enkhbold470/spinner/media/bottom.png

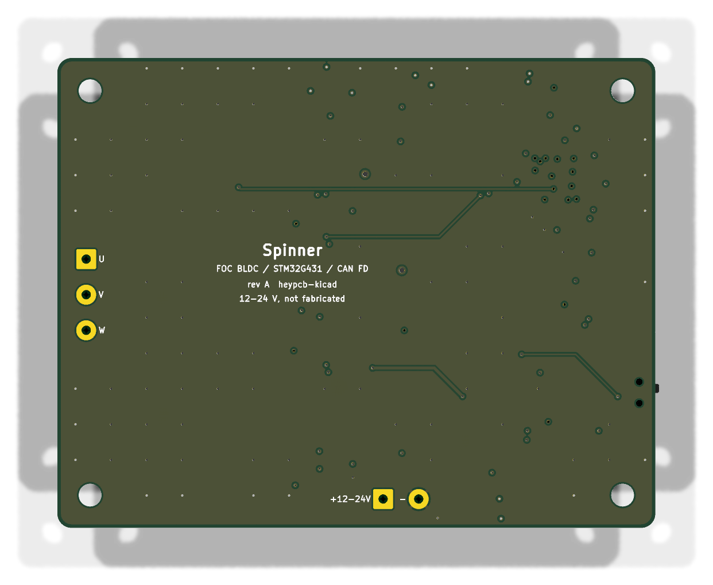
media/bottom.png
