enkhbold470/spinner/media/top.png

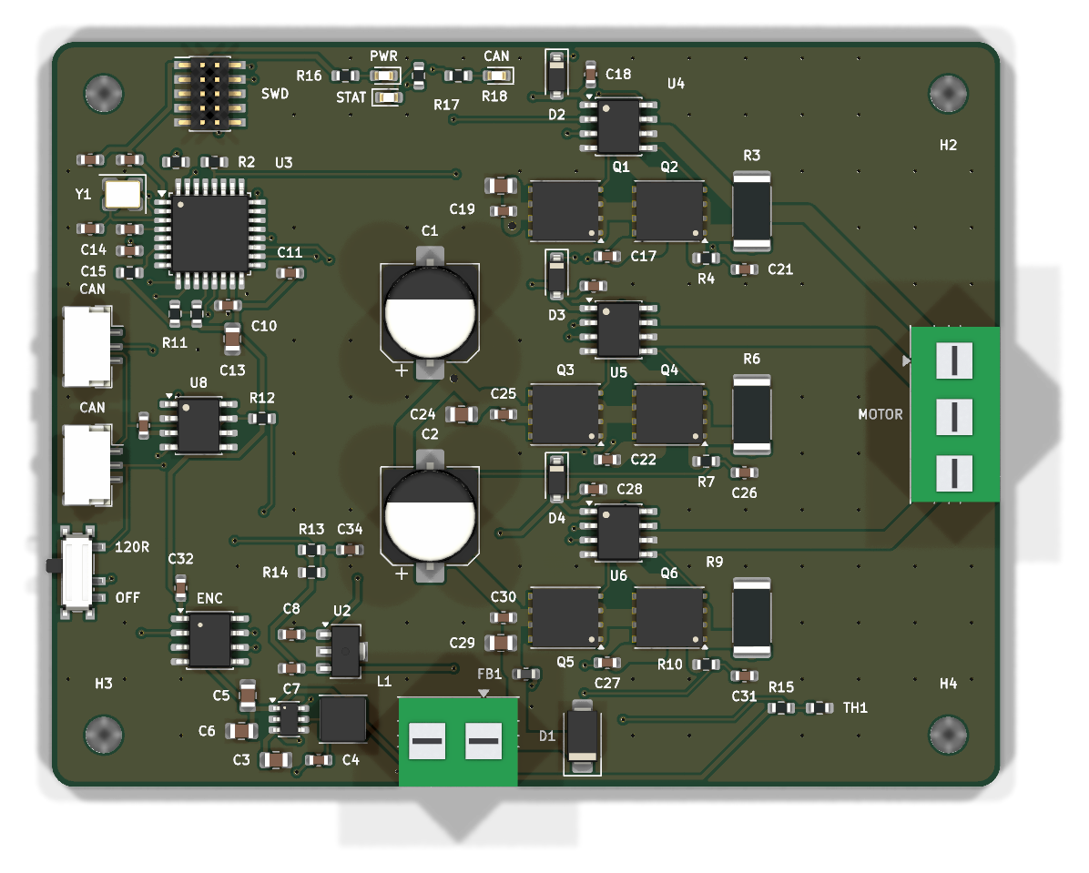
media/top.png
