enkhbold470/spinner/fab/spinner_bom.csv

Reference | Value | Footprint | MPN | LCSC | Qty
C1,C2 | 220uF 35V | Capacitor_SMD:CP_Elec_8x10.5 | UCD1V221MNL1GS | C136294 | 2
C3,C19,C24,C29 | 10uF 50V | Capacitor_SMD:C_0805_2012Metric | GRM21BR61H106KE43L | C440198 | 4
C4,C9,C10,C11,C14,C20,C25,C30,C32,C33,C34 | 100nF | Capacitor_SMD:C_0603_1608Metric | CC0603KRX7R9BB104 | C14663 | 11
C5,C6 | 22uF | Capacitor_SMD:C_0805_2012Metric | CL21A226MAQNNNE | C45783 | 2
C7,C8,C12,C17,C18,C22,C23,C27,C28 | 1uF | Capacitor_SMD:C_0603_1608Metric | CL10A105KB8NNNC | C15849 | 9
C13 | 4.7uF | Capacitor_SMD:C_0805_2012Metric | CL21A475KAQNNNE | C1779 | 1
C15,C16 | 12pF | Capacitor_SMD:C_0603_1608Metric | CL10C120JB8NNNC | C38523 | 2
C21,C26,C31 | 1nF | Capacitor_SMD:C_0603_1608Metric | CL10B102KB8NNNC | C1588 | 3
D1 | SMAJ24A | Diode_SMD:D_SMA | SMAJ24A | C19077541 | 1
D2,D3,D4 | B5819W | Diode_SMD:D_SOD-123 | B5819W SL | C8598 | 3
D5 | Green (PWR) | LED_SMD:LED_0603_1608Metric | KT-0603G | C12624 | 1
D6 | Red (STAT) | LED_SMD:LED_0603_1608Metric | KT-0603R | C2286 | 1
D7 | Orange (CAN) | LED_SMD:LED_0603_1608Metric | XL-1608UOC-06 | C965800 | 1
FB1 | 120R@100MHz | Inductor_SMD:L_0603_1608Metric | BLM18PG121SN1D | C14709 | 1
J1 | VIN 12-24V | TerminalBlock:TerminalBlock_MaiXu_MX126-5.0-02P_1x02_P5.00mm | MX126-5.0-02P-GN01-Cu-S-A | C5188434 | 1
J2 | SWD | Connector_PinHeader_1.27mm:PinHeader_2x05_P1.27mm_Vertical_SMD | PZ127VS-12-10-H10-A38 | C2935458 | 1
J3 | MOTOR | TerminalBlock:TerminalBlock_MaiXu_MX126-5.0-03P_1x03_P5.00mm | MX126-5.0-03P-GN01-Cu-S-A | C5188435 | 1
J4,J5 | CAN | Connector_JST:JST_GH_SM03B-GHS-TB_1x03-1MP_P1.25mm_Horizontal | SM03B-GHS-TB(LF)(SN) | C514175 | 2
L1 | 3.9uH | Inductor_SMD:L_Changjiang_FNR4030S | FNR4030S3R9MT | C167872 | 1
Q1,Q2,Q3,Q4,Q5,Q6 | BSC028N06LS3 | Package_TO_SOT_SMD:TDSON-8-1 | BSC028N06LS3 G | C534316 | 6
R1,R14,R15 | 4.7k | Resistor_SMD:R_0603_1608Metric | 0603WAF4701T5E | C23162 | 3
R2,R13 | 100k | Resistor_SMD:R_0603_1608Metric | 0603WAF1003T5E | C25803 | 2
R3,R6,R9 | 10mΩ | Resistor_SMD:R_2512_6332Metric | PA2512FKE7T0R01E | C375691 | 3
R4,R7,R10,R17,R18 | 1k | Resistor_SMD:R_0603_1608Metric | 0603WAF1001T5E | C21190 | 5
R5,R8,R11 | 33k | Resistor_SMD:R_0603_1608Metric | 0603WAF3302T5E | C4216 | 3
R12 | 120 | Resistor_SMD:R_0603_1608Metric | 0603WAF1200T5E | C22787 | 1
R16 | 2.2k | Resistor_SMD:R_0603_1608Metric | 0603WAF2201T5E | C4190 | 1
SW1 | TERM | Button_Switch_SMD:SW_SPDT_PCM12 | PCM12SMTR | C221841 | 1
TH1 | 10k B3380 | Resistor_SMD:R_0603_1608Metric | NCP18XH103F03RB | C13564 | 1
U1 | AP63203WU | Package_TO_SOT_SMD:TSOT-23-6 | AP63203WU-7 | C780769 | 1
U2 | L78L12 | Package_TO_SOT_SMD:SOT-89-3 | L78L12ABUTR | C915681 | 1
U3 | STM32G431KBT6 | Package_QFP:LQFP-32_7x7mm_P0.8mm | STM32G431KBT6 | C529357 | 1
U4,U5,U6 | IR2104S | Package_SO:SOIC-8_3.9x4.9mm_P1.27mm | IR2104STRPBF | C2960 | 3
U7 | MT6701CT | Package_SO:SO-8_3.9x4.9mm_P1.27mm | MT6701CT-STD | C2856764 | 1
U8 | TCAN332G | Package_SO:SOIC-8_3.9x4.9mm_P1.27mm | TCAN332GDR | C191010 | 1
Y1 | 8MHz | Crystal:Crystal_SMD_3225-4Pin_3.2x2.5mm | TAXM8M4RDBCCT2T | C400090 | 1
