enkhbold470/spinner/fab/spinner.step

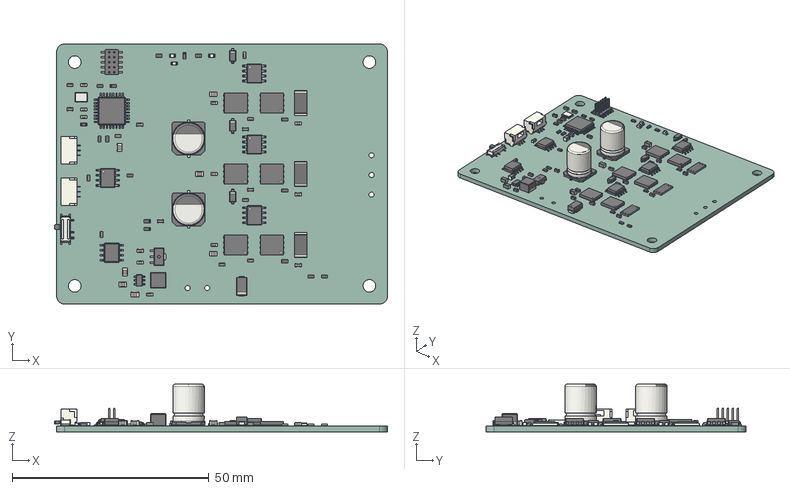
[picture p5: CAD file, 2026-10-02]
fab/spinner.step
84.5 x 66.0 x 12.1 mm
Fusion_sp
L_0603_1608Metric
R_0603_1608Metric x 16
D_SOD-123 x 3
R_2512_6332Metric x 3
C_0805_2012Metric x 7
C_0603_1608Metric x 25
SOIC-8_3.9x4.9mm_P1.27mm x 4
PinHeader_2x05_P127mm_Vertical_SMD
Crystal_SMD_3225-4Pin_3.2x2.5mm
LED_0603_1608Metric x 3
TDSON_8_1 x 6
JST_SM03B_GHS_TB x 2
CP_Elec_8x105 x 2
TSOT-23-6
L_Changjiang_FNR4030S
D_SMA
SO-8_3.9x4.9mm_P1.27mm
LQFP-32_7x7mm_P0.8mm
adbeea57-9c39-11ed-93f0-dde97e994e83_part
adbeea58-9c39-11ed-93f0-dde97e994e83_part
adbeea59-9c39-11ed-93f0-dde97e994e83_part
spinner_PCB
