enkhbold470/spinner/fab/spinner_schematic.pdf

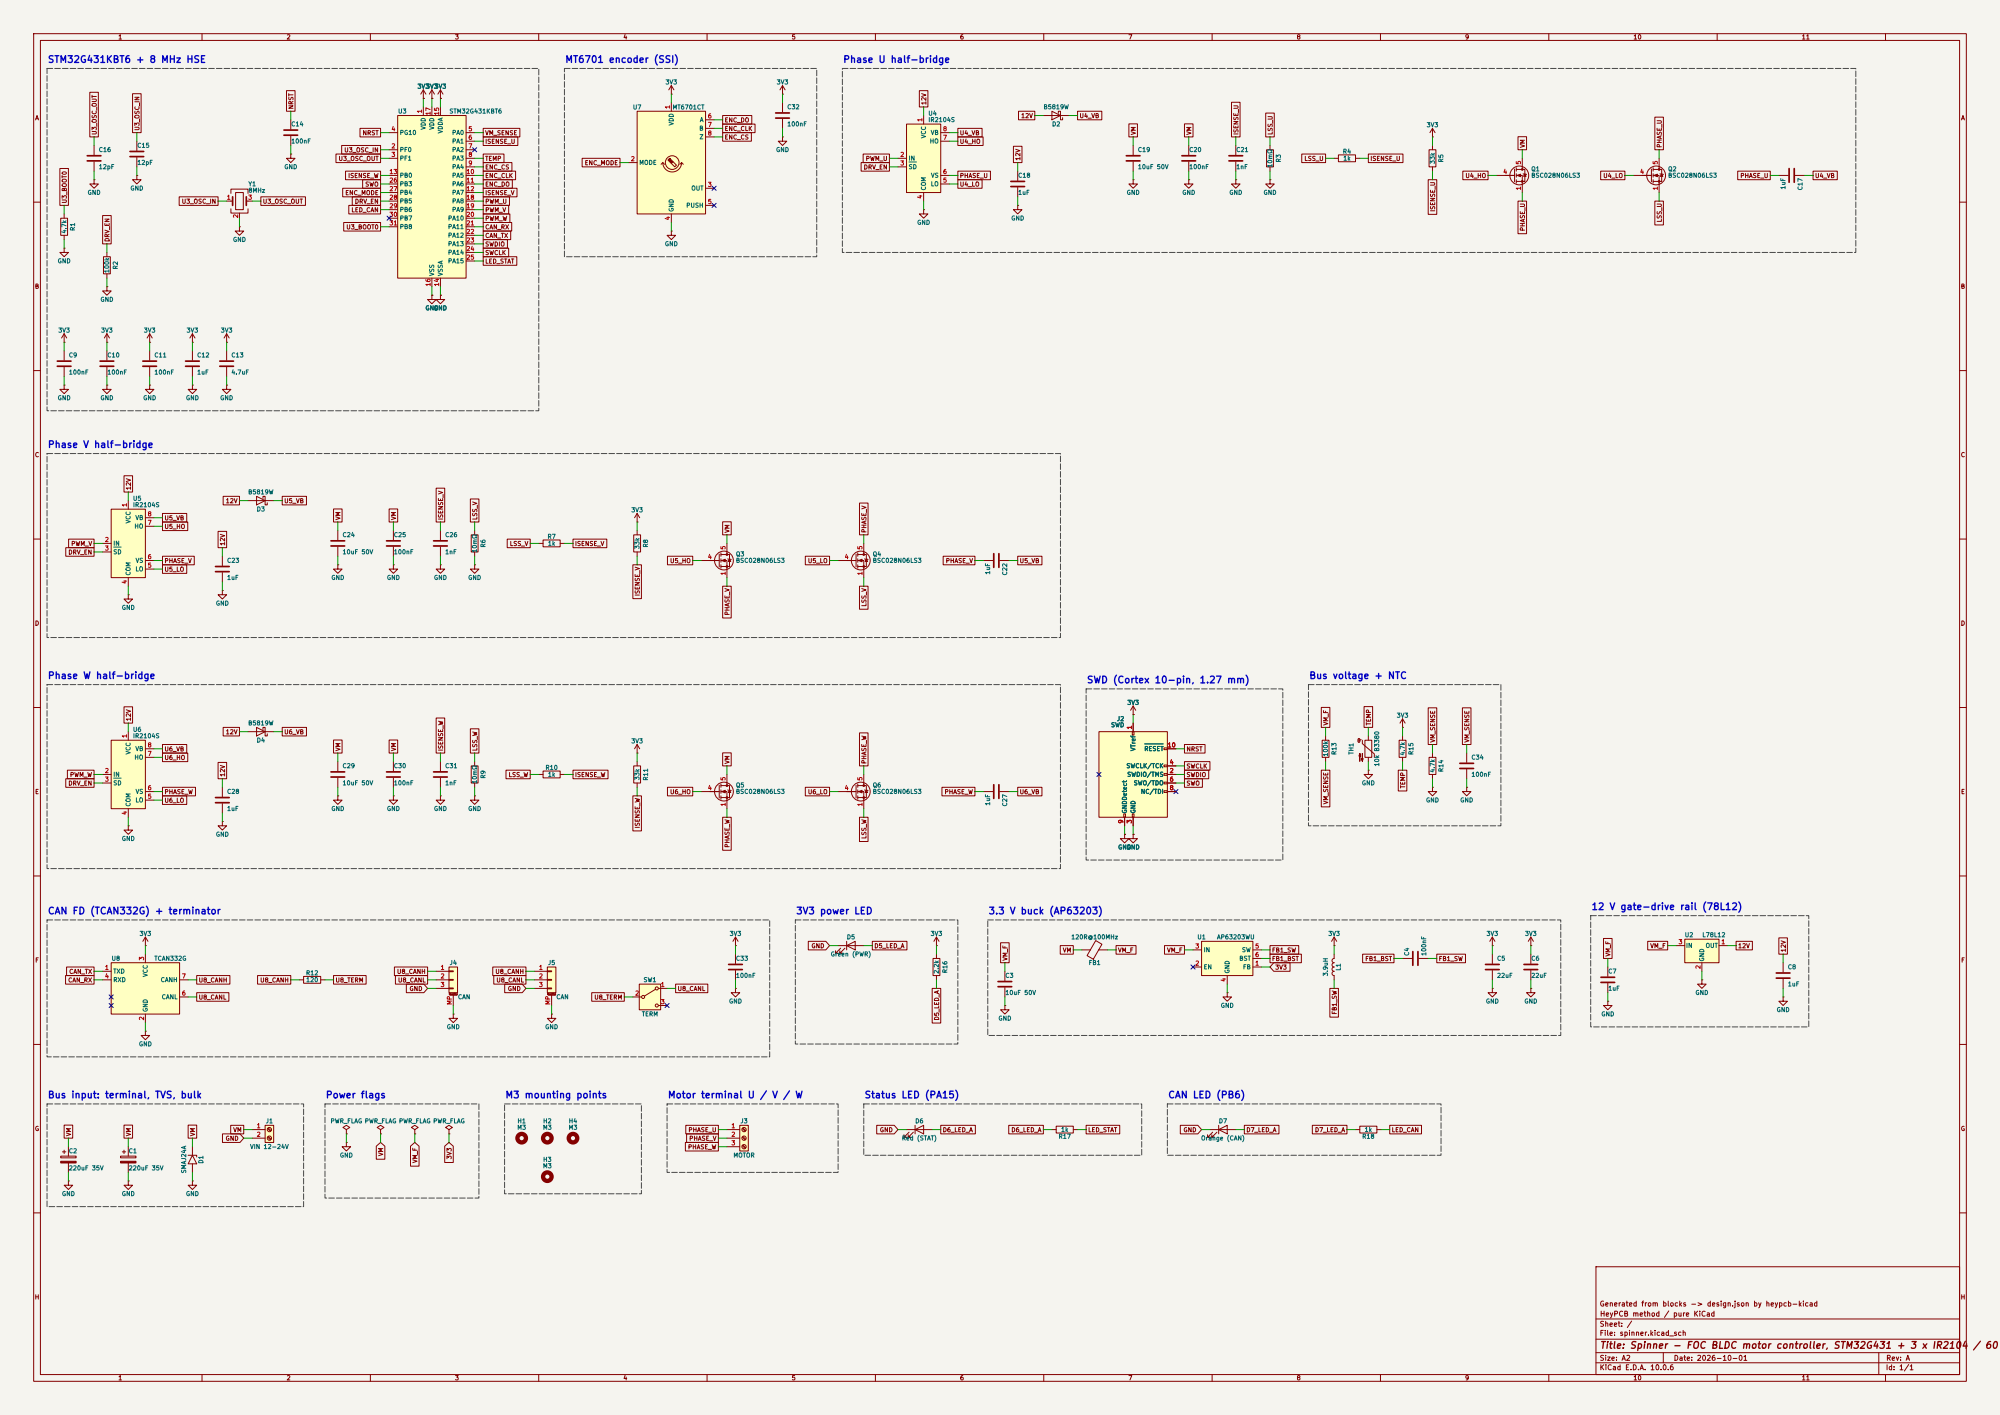
[picture p6: page 1]

1 PF0 2 PF1 3 PG10 4 PA0 5 PA1 6 PA2 7 PA3 8 PA4 9 PA5 10 PA6 11 PA7 12 PB0 13 VSSA 14 VDDA 15 VSS 16 VDD 17 PA8 18 PA9 19 PA10 20 PA11 21 PA12 22 PA13 23 PA14 24 PA15 25 PB3 26 PB4 27 PB5 28 PB6 29 PB7 30 PB8 31U3 STM32G431KBT6 GND

Bus voltage + NTC SWD (Cortex 10-pin, 1.27 mm)
3V3 GNDGND

3 RXD 4 CANL 6 CANH 7 U8 TCAN332G VCC

12 V gate-drive rail (78L12) 3V3 power LED

Bus input: terminal, TVS, bulk

Generated from blocks -> design.json by heypcb-kicad
HeyPCB method / pure KiCad
Sheet: /
File: spinner.kicad_sch
Title: Spinner - FOC BLDC motor controller, STM32G431 + 3 x IR2104 / 60 V MOSFETs, MT6701, CAN FD

Size: A2 | Rev: A
KiCad E.D.A. 10.0.6 | Id: 1/1
