enkhbold470/spinner/kicad/spinner.kicad_pcb

## KiCad design kicad/spinner.kicad_pcb (2026-10-02)

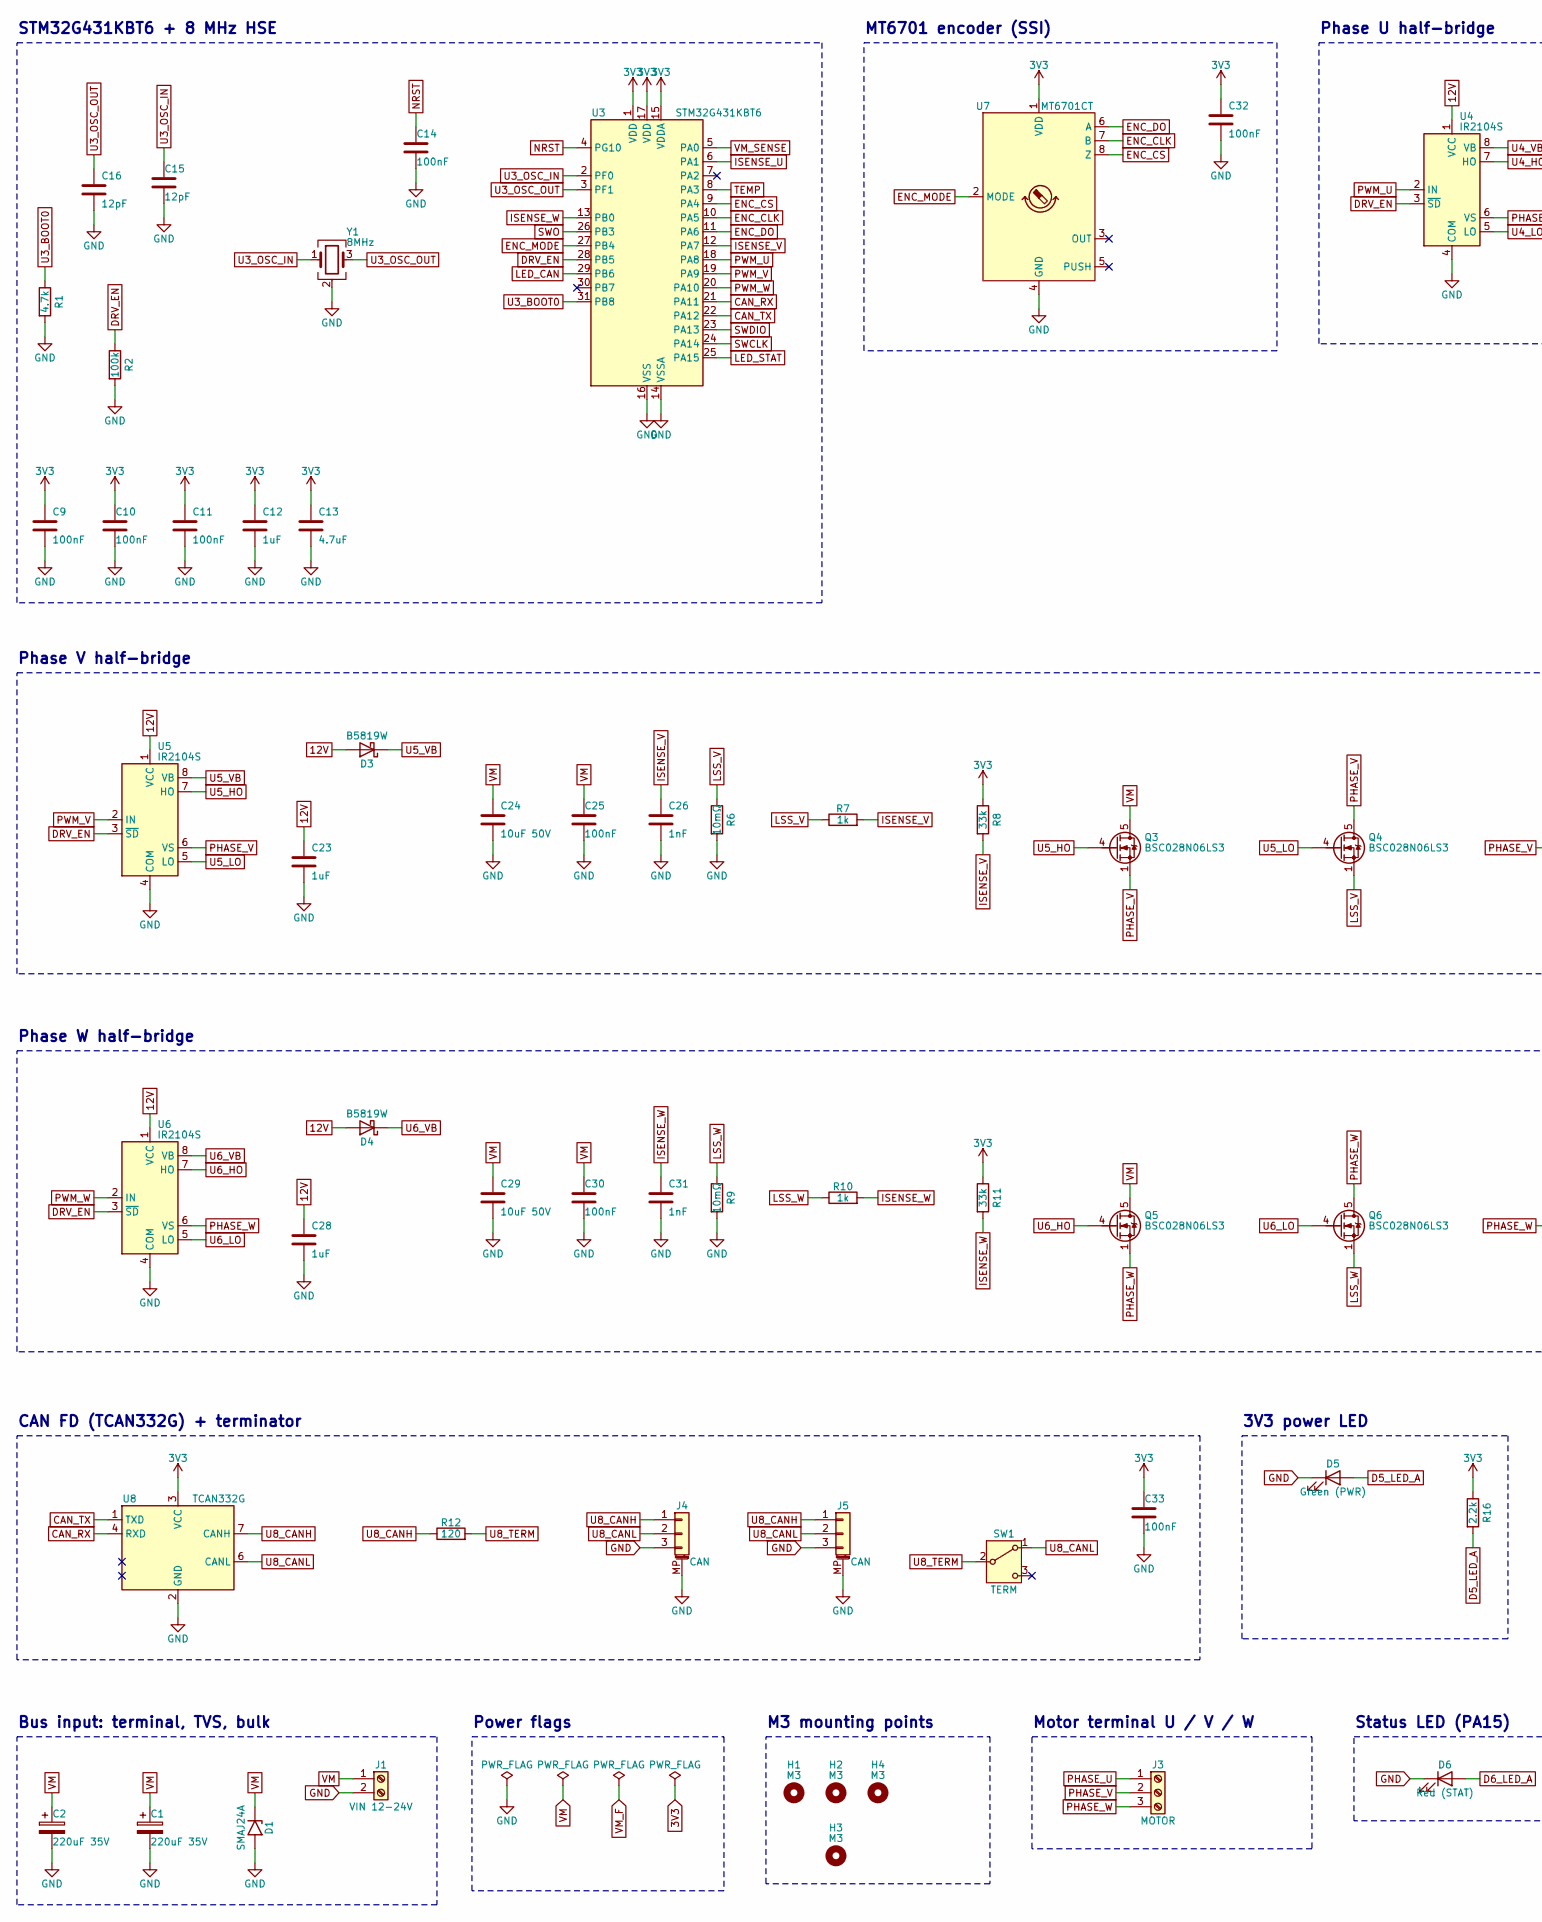
[picture p7: schematic spinner.kicad_sch, Spinner - FOC BLDC motor controller, STM32G431 + 3 x IR2104…, part in row 1, column 1]

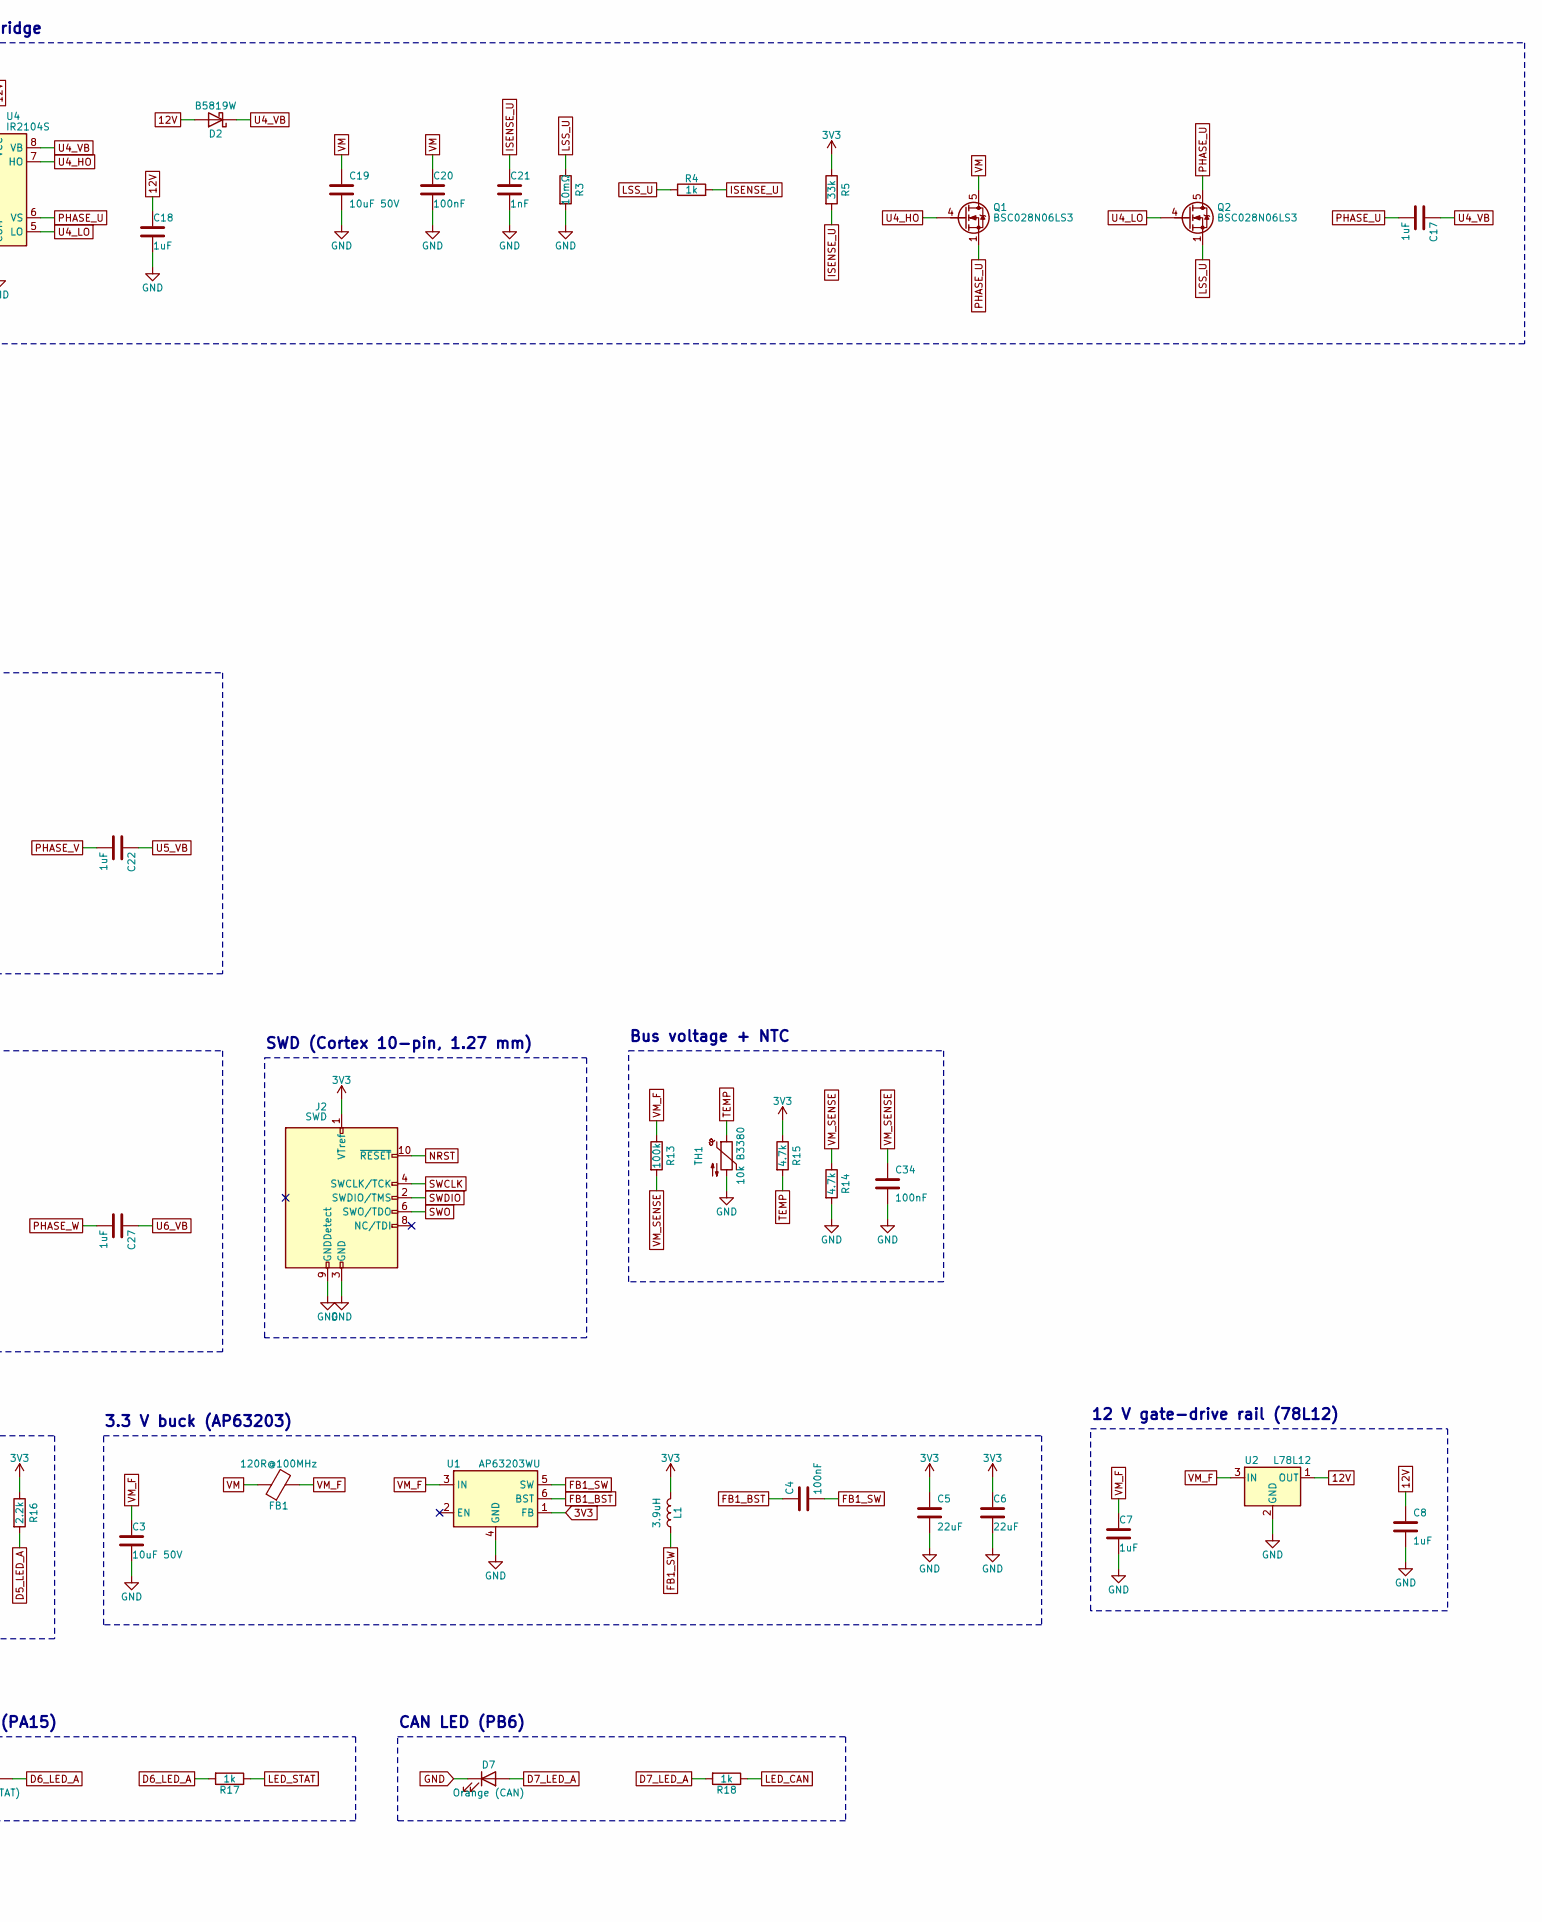
[picture p8: schematic spinner.kicad_sch, Spinner - FOC BLDC motor controller, STM32G431 + 3 x IR2104…, part in row 1, column 2]

Parts:
C1, C2: 220uF 35V; CP_Elec_8x10.5; MPN UCD1V221MNL1GS; LCSC C136294
C3, C19, C24, C29: 10uF 50V; C_0805_2012Metric; MPN GRM21BR61H106KE43L; LCSC C440198
C4, C9, C10, C11, C14, C20, C25, C30, C32, C33, C34: 100nF; C_0603_1608Metric; MPN CC0603KRX7R9BB104; LCSC C14663
C5, C6: 22uF; C_0805_2012Metric; MPN CL21A226MAQNNNE; LCSC C45783
C7, C8, C12, C17, C18, C22, C23, C27, C28: 1uF; C_0603_1608Metric; MPN CL10A105KB8NNNC; LCSC C15849
C13: 4.7uF; C_0805_2012Metric; MPN CL21A475KAQNNNE; LCSC C1779
C15, C16: 12pF; C_0603_1608Metric; MPN CL10C120JB8NNNC; LCSC C38523
C21, C26, C31: 1nF; C_0603_1608Metric; MPN CL10B102KB8NNNC; LCSC C1588
D1: SMAJ24A; D_SMA; MPN SMAJ24A; LCSC C19077541
D2, D3, D4: B5819W; D_SOD-123; MPN B5819W SL; LCSC C8598
D5: Green (PWR); LED_0603_1608Metric; MPN KT-0603G; LCSC C12624
D6: Red (STAT); LED_0603_1608Metric; MPN KT-0603R; LCSC C2286
D7: Orange (CAN); LED_0603_1608Metric; MPN XL-1608UOC-06; LCSC C965800
FB1: 120R@100MHz; L_0603_1608Metric; MPN BLM18PG121SN1D; LCSC C14709
H1, H2, H3, H4: M3; MountingHole_3.2mm_M3
J1: VIN 12-24V; TerminalBlock_MaiXu_MX126-5.0-02P_1x02_P5.00mm; MPN MX126-5.0-02P-GN01-Cu-S-A; LCSC C5188434
J2: SWD; PinHeader_2x05_P1.27mm_Vertical_SMD; MPN PZ127VS-12-10-H10-A38; LCSC C2935458
J3: MOTOR; TerminalBlock_MaiXu_MX126-5.0-03P_1x03_P5.00mm; MPN MX126-5.0-03P-GN01-Cu-S-A; LCSC C5188435
J4, J5: CAN; JST_GH_SM03B-GHS-TB_1x03-1MP_P1.25mm_Horizontal; MPN SM03B-GHS-TB(LF)(SN); LCSC C514175
L1: 3.9uH; L_Changjiang_FNR4030S; MPN FNR4030S3R9MT; LCSC C167872
Q1, Q2, Q3, Q4, Q5, Q6: BSC028N06LS3; TDSON-8-1; MPN BSC028N06LS3 G; LCSC C534316
R1, R14, R15: 4.7k; R_0603_1608Metric; MPN 0603WAF4701T5E; LCSC C23162
R2, R13: 100k; R_0603_1608Metric; MPN 0603WAF1003T5E; LCSC C25803
R3, R6, R9: 10mΩ; R_2512_6332Metric; MPN PA2512FKE7T0R01E; LCSC C375691
R4, R7, R10, R17, R18: 1k; R_0603_1608Metric; MPN 0603WAF1001T5E; LCSC C21190
R5, R8, R11: 33k; R_0603_1608Metric; MPN 0603WAF3302T5E; LCSC C4216
R12: 120; R_0603_1608Metric; MPN 0603WAF1200T5E; LCSC C22787
R16: 2.2k; R_0603_1608Metric; MPN 0603WAF2201T5E; LCSC C4190
SW1: TERM; SW_SPDT_PCM12; MPN PCM12SMTR; LCSC C221841
TH1: 10k B3380; R_0603_1608Metric; MPN NCP18XH103F03RB; LCSC C13564
U1: AP63203WU; TSOT-23-6; MPN AP63203WU-7; LCSC C780769
U2: L78L12; SOT-89-3; MPN L78L12ABUTR; LCSC C915681
U3: STM32G431KBT6; LQFP-32_7x7mm_P0.8mm; MPN STM32G431KBT6; LCSC C529357
U4, U5, U6: IR2104S; SOIC-8_3.9x4.9mm_P1.27mm; MPN IR2104STRPBF; LCSC C2960
U7: MT6701CT; SO-8_3.9x4.9mm_P1.27mm; MPN MT6701CT-STD; LCSC C2856764
U8: TCAN332G; SOIC-8_3.9x4.9mm_P1.27mm; MPN TCAN332GDR; LCSC C191010
Y1: 8MHz; Crystal_SMD_3225-4Pin_3.2x2.5mm; MPN TAXM8M4RDBCCT2T; LCSC C400090

Connections:
3V3: C5.1, C6.1, C9.1, C10.1, C11.1, C12.1, C13.1, C32.1, C33.1, J2.1 (VTref), L1.2, R5.1, R8.1, R11.1, R15.1, R16.1, U1.1 (FB), U3.1 (VDD), U3.15 (VDDA), U3.17 (VDD), U7.1 (VDD), U8.3 (VCC)
12V: C8.1, C18.1, C23.1, C28.1, D2.2 (A), D3.2 (A), D4.2 (A), U2.1 (OUT), U4.1 (VCC), U5.1 (VCC), U6.1 (VCC)
CAN_RX: U3.21 (PA11), U8.4 (RXD)
CAN_TX: U3.22 (PA12), U8.1 (TXD)
D5_LED_A: D5.2 (A), R16.2
D6_LED_A: D6.2 (A), R17.2
D7_LED_A: D7.2 (A), R18.2
DRV_EN: R2.1, U3.28 (PB5), U4.3 (~SD), U5.3 (~SD), U6.3 (~SD)
ENC_CLK: U3.10 (PA5), U7.7 (B)
ENC_CS: U3.9 (PA4), U7.8 (Z)
ENC_DO: U3.11 (PA6), U7.6 (A)
ENC_MODE: U3.27 (PB4), U7.2 (MODE)
FB1_BST: C4.1, U1.6 (BST)
FB1_SW: C4.2, L1.1, U1.5 (SW)
GND: C1.2, C2.2, C3.2, C5.2, C6.2, C7.2, C8.2, C9.2, C10.2, C11.2, C12.2, C13.2, C14.2, C15.2, C16.2, C18.2, C19.2, C20.2, C21.2, C23.2, C24.2, C25.2, C26.2, C28.2, C29.2, C30.2, C31.2, C32.2, C33.2, C34.2, D1.2 (A2), D5.1 (K), D6.1 (K), D7.1 (K), J1.2, J2.3 (GND), J2.5 (GND), J2.9 (GNDDetect), J4.3, J4.MP (MountPin), J5.3, J5.MP (MountPin), R1.2, R2.2, R3.2, R6.2, R9.2, R14.2, TH1.2, U1.4 (GND), U2.2 (GND), U3.14 (VSSA), U3.16 (VSS), U3.32 (VSS), U4.4 (COM), U5.4 (COM), U6.4 (COM), U7.4 (GND), U8.2 (GND), Y1.2 (G), Y1.4 (G)
ISENSE_U: C21.1, R4.2, R5.2, U3.6 (PA1)
ISENSE_V: C26.1, R7.2, R8.2, U3.12 (PA7)
ISENSE_W: C31.1, R10.2, R11.2, U3.13 (PB0)
LED_CAN: R18.1, U3.29 (PB6)
LED_STAT: R17.1, U3.25 (PA15)
LSS_U: Q2.1 (S), Q2.2 (S), Q2.3 (S), R3.1, R4.1
LSS_V: Q4.1 (S), Q4.2 (S), Q4.3 (S), R6.1, R7.1
LSS_W: Q6.1 (S), Q6.2 (S), Q6.3 (S), R9.1, R10.1
NRST: C14.1, J2.10 (~RESET), U3.4 (PG10)
PHASE_U: C17.2, J3.1, Q1.1 (S), Q1.2 (S), Q1.3 (S), Q2.5 (D), U4.6 (VS)
PHASE_V: C22.2, J3.2, Q3.1 (S), Q3.2 (S), Q3.3 (S), Q4.5 (D), U5.6 (VS)
PHASE_W: C27.2, J3.3, Q5.1 (S), Q5.2 (S), Q5.3 (S), Q6.5 (D), U6.6 (VS)
PWM_U: U3.18 (PA8), U4.2 (IN)
PWM_V: U3.19 (PA9), U5.2 (IN)
PWM_W: U3.20 (PA10), U6.2 (IN)
SWCLK: J2.4 (SWCLK/TCK), U3.24 (PA14)
SWDIO: J2.2 (SWDIO/TMS), U3.23 (PA13)
SWO: J2.6 (SWO/TDO), U3.26 (PB3)
TEMP: R15.2, TH1.1, U3.8 (PA3)
U3_BOOT0: R1.1, U3.31 (PB8)
U3_OSC_IN: C15.1, U3.2 (PF0), Y1.1
U3_OSC_OUT: C16.1, U3.3 (PF1), Y1.3
U4_HO: Q1.4 (G), U4.7 (HO)
U4_LO: Q2.4 (G), U4.5 (LO)
U4_VB: C17.1, D2.1 (K), U4.8 (VB)
U5_HO: Q3.4 (G), U5.7 (HO)
U5_LO: Q4.4 (G), U5.5 (LO)
U5_VB: C22.1, D3.1 (K), U5.8 (VB)
U6_HO: Q5.4 (G), U6.7 (HO)
U6_LO: Q6.4 (G), U6.5 (LO)
U6_VB: C27.1, D4.1 (K), U6.8 (VB)
U8_CANH: J4.1, J5.1, R12.1, U8.7 (CANH)
U8_CANL: J4.2, J5.2, SW1.1 (A), U8.6 (CANL)
U8_TERM: R12.2, SW1.2 (B)
VM: C1.1, C2.1, C19.1, C20.1, C24.1, C25.1, C29.1, C30.1, D1.1 (A1), FB1.1, J1.1, Q1.5 (D), Q3.5 (D), Q5.5 (D)
VM_F: C3.1, C7.1, FB1.2, R13.1, U1.3 (IN), U2.3 (IN)
VM_SENSE: C34.1, R13.2, R14.1, U3.5 (PA0)

Notes on the sheet:
Bus input: terminal, TVS, bulk
3.3 V buck (AP63203)
12 V gate-drive rail (78L12)
STM32G431KBT6 + 8 MHz HSE
SWD (Cortex 10-pin, 1.27 mm)
Phase U half-bridge
Phase V half-bridge
Phase W half-bridge
Motor terminal U / V / W
MT6701 encoder (SSI)
CAN FD (TCAN332G) + terminator
Bus voltage + NTC
3V3 power LED
Status LED (PA15)
CAN LED (PB6)
M3 mounting points
Power flags

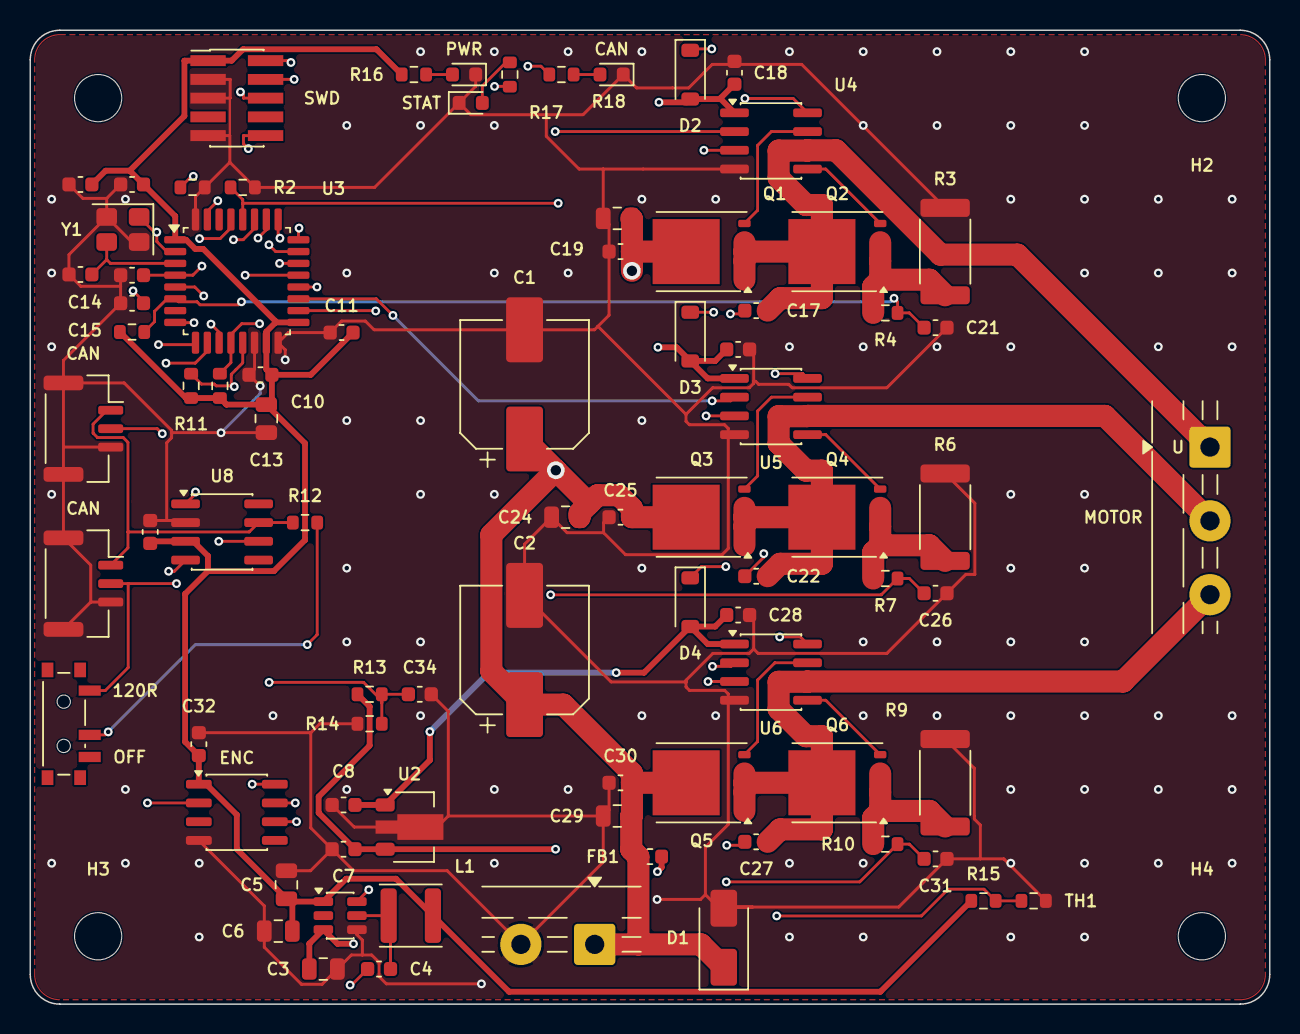
[picture p9: board spinner.kicad_pcb from above]

Board: 4 copper layers, 84.0 x 66.0 mm, 87 parts (0 on the bottom side), 52 nets.
